GameOfKnowing/ACT_Charger/README.md

# ACT_Charger
A modular, Arduino-based charger for charging and measuring the capacities of many small lithium-polymer batteries
