GameOfKnowing/ACT_Charger/Case/ACT Charger Enclosure Lid.stl

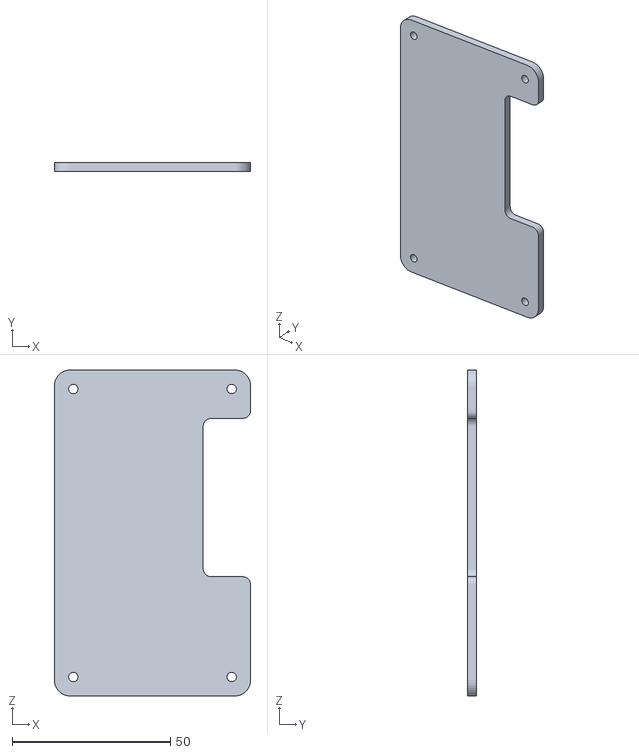
[picture p1: CAD file, 2017-07-28]
Case/ACT Charger Enclosure Lid.stl
62.0 x 3.00 x 103.0
