GameOfKnowing/ACT_Charger/Case/ACT Charger Enclosure Body.stl

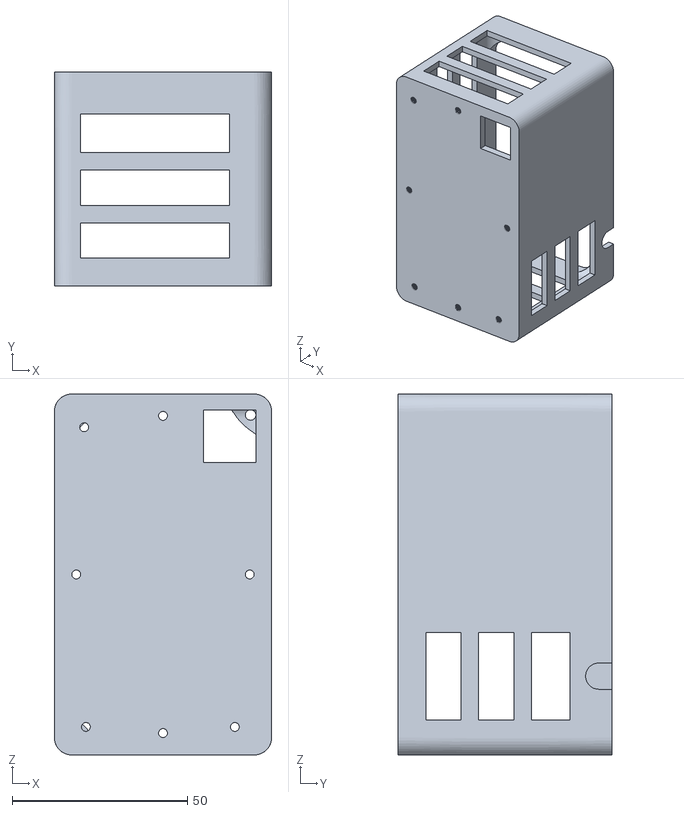
[picture p2: CAD file, 2017-07-28]
Case/ACT Charger Enclosure Body.stl
62.0 x 61.0 x 103.0
