GameOfKnowing/ACT_Charger/EAGLE Files/ACT Lipoly Charger R3 FINAL.brd

## EAGLE design EAGLE Files/ACT Lipoly Charger R3 FINAL.brd (2017-10-17)

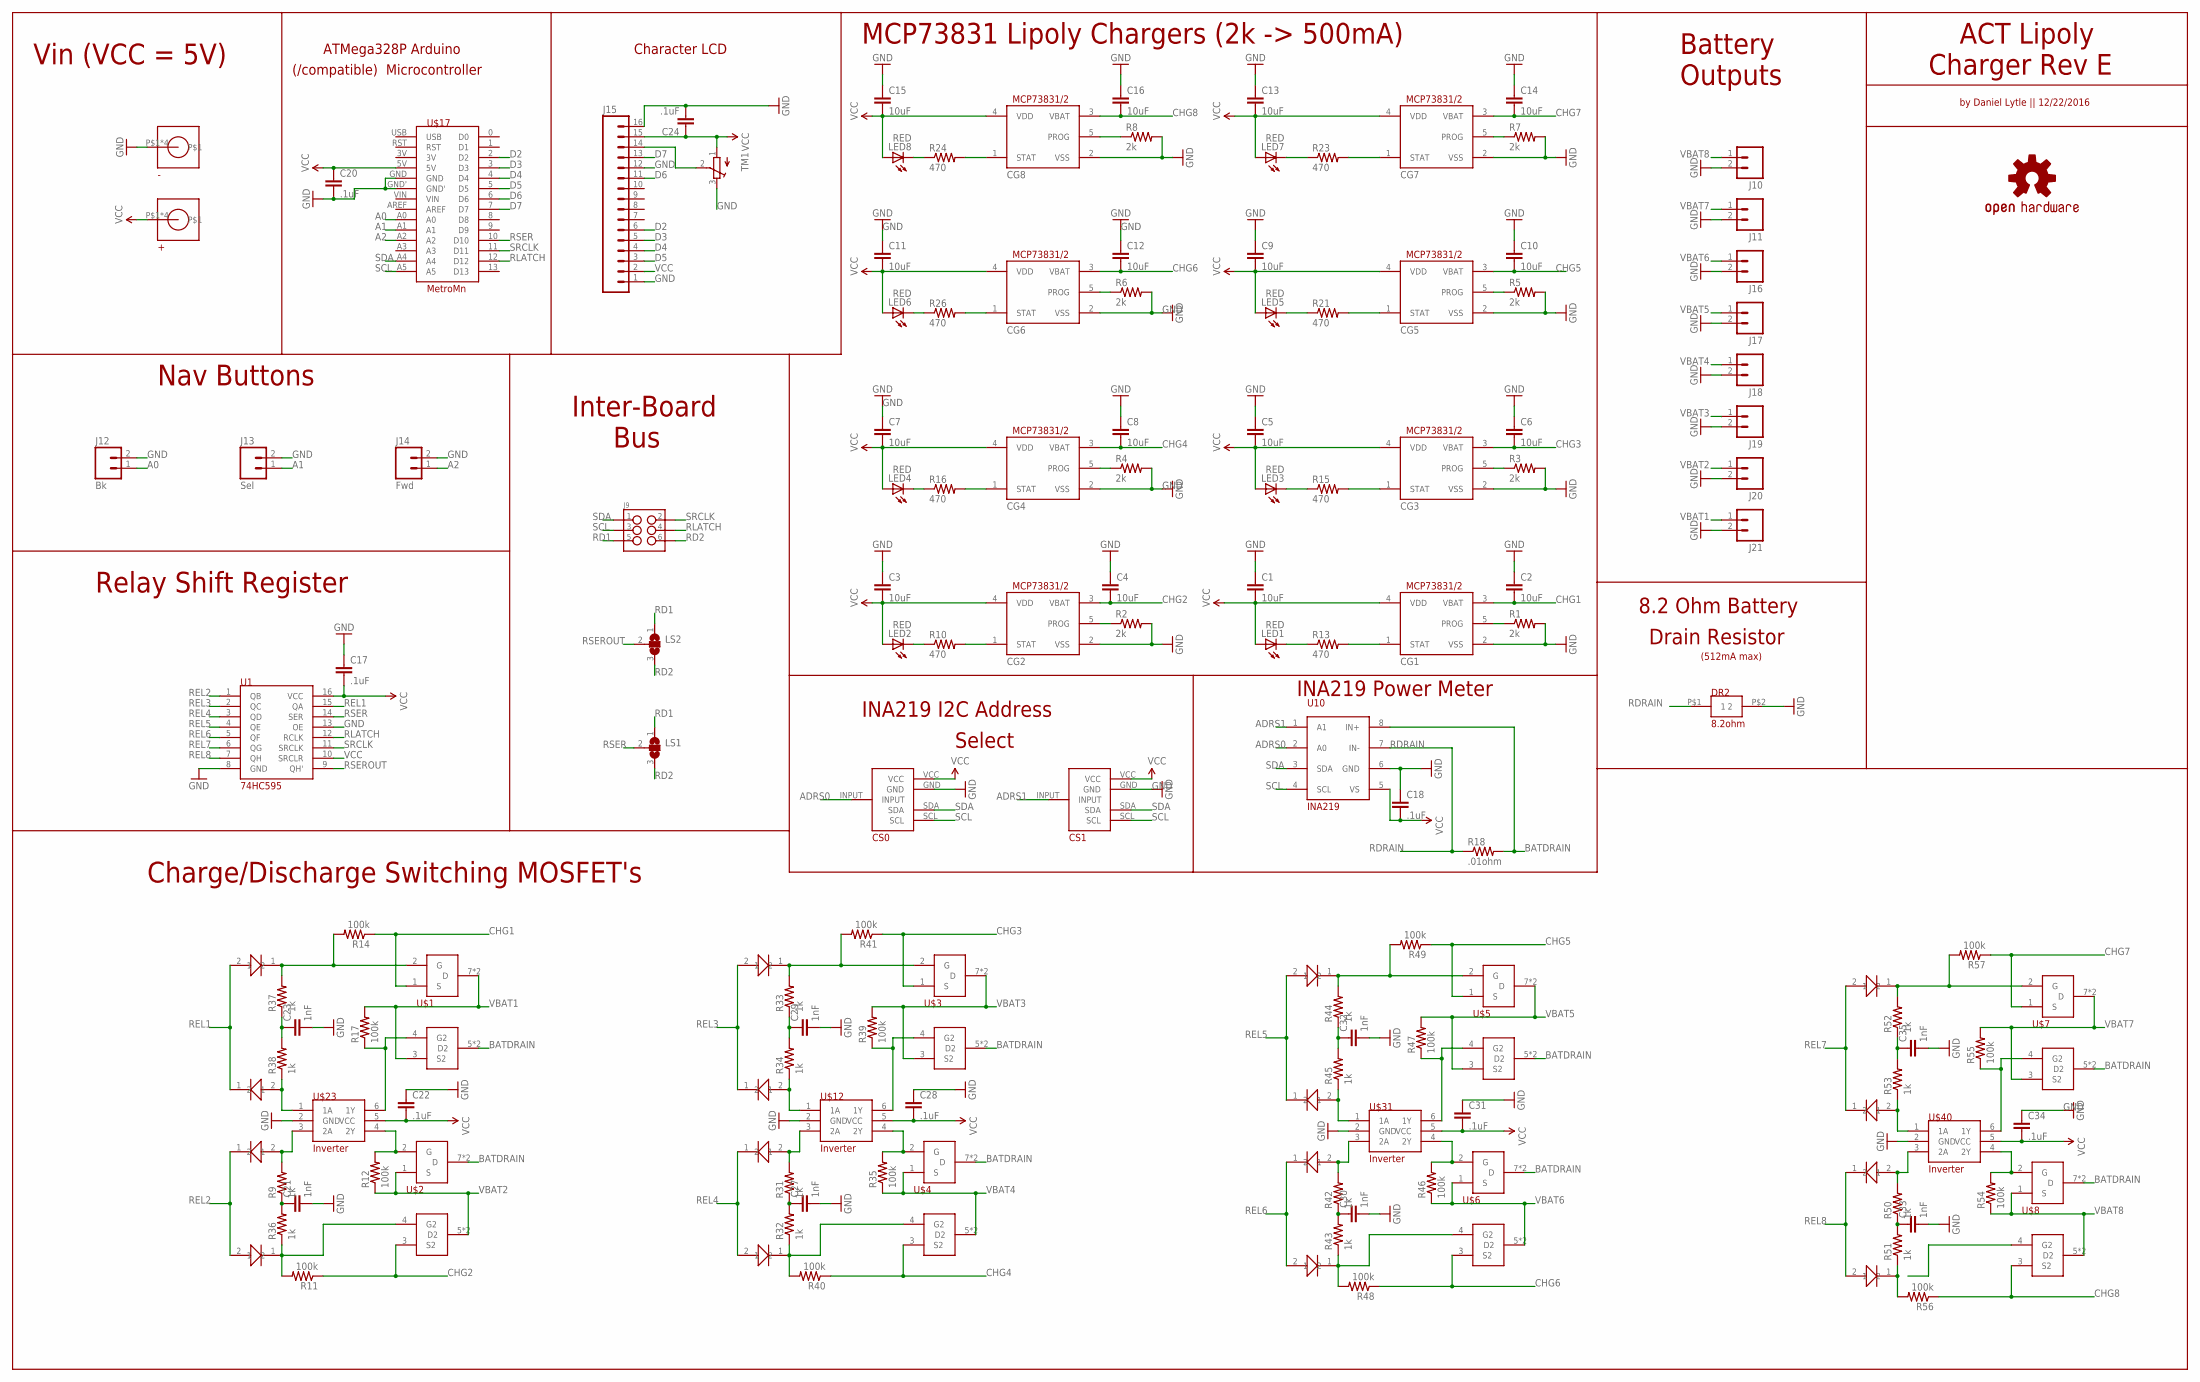
[picture p3: schematic ACT Lipoly Charger R3 FINAL.sch]

Parts:
+: 8191-SEMS; 9191-SEMS
-: 8191-SEMS; 9191-SEMS
C1, C2, C3, C4, C5, C6, C7, C8, C9, C10, C11, C12, C13, C14, C15, C16: 10uF; 0805
C17, C18, C20, C22, C24, C28, C31, C34: .1uF; 0805
C21, C23, C27, C29, C30, C32, C33, C35: 1nF; 0805
CG1, CG2, CG3, CG4, CG5, CG6, CG7, CG8: MCP73831/OT; SOT23-5L
CS0, CS1: 4-WAYSELECTOR
DR2: 8.2ohm; UB5C-5R6F1
J9: M03X2FEMALE; 2X3
J10, J11, J16, J17, J18, J19, J20, J21: M02LOCK_LONGPADS; 1X02_LOCK_LONGPADS
J12: Bk; 1X02_LOCK_LONGPADS
J13: Sel; 1X02_LOCK_LONGPADS
J14: Fwd; 1X02_LOCK_LONGPADS
J15: M16LOCK_LONGPADS; 1X16_LOCK_LONGPADS
LED1, LED2, LED3, LED4, LED5, LED6, LED7, LED8: RED; CHIP-LED0805
LS1, LS2: SJ2W; SJ_2
R1, R2, R3, R4, R5, R6, R7, R8: 2k; 0805
R9, R31, R32, R33, R34, R36, R37, R38, R42, R43, R44, R45, R50, R51, R52, R53: 1k; 0805
R10, R13, R15, R16, R21, R23, R24, R26: 470; 0805
R11, R12, R14, R17, R35, R39, R40, R41, R46, R47, R48, R49, R54, R55, R56, R57: 100k; 0805
R18: .01ohm; 0805
TM1: TRIMPOTTC33X; TC33X
U1: 74HC595; DIL16
U10: INA219; SOIC8
U$1, U$2, U$3, U$4, U$5, U$6, U$7, U$8: DMP3085LSD; SOIC8
U$12, U$23, U$31, U$40: Inverter; SOT363_PHILIPS
U$15, U$16, U$18, U$19, U$26, U$27, U$28, U$29, U$34, U$35, U$36, U$37, U$43, U$44, U$45, U$46: DA2J10100L_DIODE; SOD323
U$17: MetroMn; ADAFRUIT_METRO_MINI
VCC: OSHW-LOGOM-COPPER; OSHW-LOGO-M_COPPER

Connections:
A0: J12.1, U$17.A0
A1: J13.1, U$17.A1
A2: J14.1, U$17.A2
ADRS0: CS0.INPUT, U10.2 (A0)
ADRS1: CS1.INPUT, U10.1 (A1)
BATDRAIN: R18.2, U10.8 (IN+), U$1.5 (D2), U$1.6 (D2), U$2.7 (D), U$2.8 (D), U$3.5 (D2), U$3.6 (D2), U$4.7 (D), U$4.8 (D), U$5.5 (D2), U$5.6 (D2), U$6.7 (D), U$6.8 (D), U$7.5 (D2), U$7.6 (D2), U$8.7 (D), U$8.8 (D)
CHG1: C2.2, CG1.3 (VBAT), R14.1, U$1.1 (S)
CHG2: C4.2, CG2.3 (VBAT), R11.1, U$2.3 (S2)
CHG3: C6.2, CG3.3 (VBAT), R41.1, U$3.1 (S)
CHG4: C8.2, CG4.3 (VBAT), R40.1, U$4.3 (S2)
CHG5: C10.2, CG5.3 (VBAT), R49.1, U$5.1 (S)
CHG6: C12.2, CG6.3 (VBAT), R48.1, U$6.3 (S2)
CHG7: C14.2, CG7.3 (VBAT), R57.1, U$7.1 (S)
CHG8: C16.2, CG8.3 (VBAT), R56.1, U$8.3 (S2)
D2: J15.6, U$17.2 (D2)
D3: J15.5, U$17.3 (D3)
D4: J15.4, U$17.4 (D4)
D5: J15.3, U$17.5 (D5)
D6: J15.11, U$17.6 (D6)
D7: J15.13, U$17.7 (D7)
GND: -.P$1, -.P$2, -.P$3, -.P$4, C1.1, C2.1, C3.1, C4.1, C5.1, C6.1, C7.1, C8.1, C9.1, C10.1, C11.1, C12.1, C13.1, C14.1, C15.1, C16.1, C17.1, C18.1, C20.2, C21.2, C22.1, C23.2, C24.2, C27.2, C28.1, C29.2, C30.2, C31.1, C32.2, C33.2, C34.1, C35.2, CG1.2 (VSS), CG2.2 (VSS), CG3.2 (VSS), CG4.2 (VSS), CG5.2 (VSS), CG6.2 (VSS), CG7.2 (VSS), CG8.2 (VSS), CS0.GND, CS1.GND, DR2.P$2 (2), J10.2, J11.2, J12.2, J13.2, J14.2, J15.1, J15.12, J15.16, J16.2, J17.2, J18.2, J19.2, J20.2, J21.2, R1.2, R2.2, R3.2, R4.2, R5.2, R6.2, R7.2, R8.2, TM1.3 (E), U1.8 (GND), U1.13 (OE), U10.6 (GND), U$12.2 (GND), U$17.GND, U$17.GND', U$23.2 (GND), U$31.2 (GND), U$40.2 (GND)
unnamed: CG7.1 (STAT), R23.2
unnamed: CG8.5 (PROG), R8.1
unnamed: LED7.C, R23.1
unnamed: CG7.5 (PROG), R7.1
unnamed: CG6.5 (PROG), R6.1
unnamed: CG8.1 (STAT), R24.2
unnamed: CG5.5 (PROG), R5.1
unnamed: CG4.5 (PROG), R4.1
unnamed: LED8.C, R24.1
unnamed: CG3.5 (PROG), R3.1
unnamed: CG2.5 (PROG), R2.1
unnamed: LED6.C, R26.1
unnamed: CG1.5 (PROG), R1.1
unnamed: CG6.1 (STAT), R26.2
unnamed: CG4.1 (STAT), R16.2
unnamed: LED4.C, R16.1
unnamed: LED5.C, R21.1
unnamed: CG5.1 (STAT), R21.2
unnamed: LED3.C, R15.1
unnamed: CG3.1 (STAT), R15.2
unnamed: LED1.C, R13.1
unnamed: CG1.1 (STAT), R13.2
unnamed: CG2.1 (STAT), R10.2
unnamed: LED2.C, R10.1
unnamed: J15.14, TM1.2 (S)
unnamed: R38.1, U$23.1 (1A), U$29.2
unnamed: R9.2, U$23.3 (2A), U$28.2
unnamed: C21.1, R9.1, R36.2
unnamed: R11.2, R36.1, U$2.4 (G2), U$26.1
unnamed: R12.2, U$2.2 (G), U$23.4 (2Y)
unnamed: R17.1, U$1.4 (G2), U$23.6 (1Y)
unnamed: C23.1, R37.1, R38.2
unnamed: R14.2, R37.2, U$1.2 (G), U$27.1
unnamed: R31.2, U$12.3 (2A), U$16.2
unnamed: C27.1, R31.1, R32.2
unnamed: R32.1, R40.2, U$4.4 (G2), U$15.1
unnamed: R35.2, U$4.2 (G), U$12.4 (2Y)
unnamed: R34.1, U$12.1 (1A), U$19.2
unnamed: R39.1, U$3.4 (G2), U$12.6 (1Y)
unnamed: R33.2, R41.2, U$3.2 (G), U$18.1
unnamed: C29.1, R33.1, R34.2
unnamed: R42.2, U$31.3 (2A), U$35.2
unnamed: C30.1, R42.1, R43.2
unnamed: R43.1, R48.2, U$6.4 (G2), U$34.1
unnamed: R46.2, U$6.2 (G), U$31.4 (2Y)
unnamed: R45.1, U$31.1 (1A), U$37.2
unnamed: R47.1, U$5.4 (G2), U$31.6 (1Y)
unnamed: R44.2, R49.2, U$5.2 (G), U$36.1
unnamed: C32.1, R44.1, R45.2
unnamed: R50.2, U$40.3 (2A), U$44.2
unnamed: C33.1, R50.1, R51.2
unnamed: R51.1, R56.2, U$43.1
unnamed: R54.2, U$8.2 (G), U$40.4 (2Y)
unnamed: R53.1, U$40.1 (1A), U$46.2
unnamed: R55.1, U$7.4 (G2), U$40.6 (1Y)
unnamed: R52.2, R57.2, U$7.2 (G), U$45.1
unnamed: C35.1, R52.1, R53.2
RD1: J9.5, LS1.1, LS2.1
RD2: J9.6, LS1.3, LS2.3
RDRAIN: DR2.P$1 (1), R18.1, U10.7 (IN-)
REL1: U1.15 (QA), U$27.2, U$29.1
REL2: U1.1 (QB), U$26.2, U$28.1
REL3: U1.2 (QC), U$18.2, U$19.1
REL4: U1.3 (QD), U$15.2, U$16.1
REL5: U1.4 (QE), U$36.2, U$37.1
REL6: U1.5 (QF), U$34.2, U$35.1
REL7: U1.6 (QG), U$45.2, U$46.1
REL8: U1.7 (QH), U$43.2, U$44.1
RLATCH: J9.4, U1.12 (RCLK), U$17.12 (D12)
RSER: LS1.2, U1.14 (SER), U$17.10 (D10)
RSEROUT: LS2.2, U1.9 (QH')
SCL: CS0.SCL, CS1.SCL, J9.3, U10.4 (SCL), U$17.A5
SDA: CS0.SDA, CS1.SDA, J9.1, U10.3 (SDA), U$17.A4
SRCLK: J9.2, U1.11 (SRCLK), U$17.11 (D11)
VBAT1: J21.1, R17.2, U$1.3 (S2), U$1.7 (D), U$1.8 (D)
VBAT2: J20.1, R12.1, U$2.1 (S), U$2.5 (D2), U$2.6 (D2)
VBAT3: J19.1, R39.2, U$3.3 (S2), U$3.7 (D), U$3.8 (D)
VBAT4: J18.1, R35.1, U$4.1 (S), U$4.5 (D2), U$4.6 (D2)
VBAT5: J17.1, R47.2, U$5.3 (S2), U$5.7 (D), U$5.8 (D)
VBAT6: J16.1, R46.1, U$6.1 (S), U$6.5 (D2), U$6.6 (D2)
VBAT7: J11.1, R55.2, U$7.3 (S2), U$7.7 (D), U$7.8 (D)
VBAT8: J10.1, R54.1, U$8.1 (S), U$8.5 (D2), U$8.6 (D2)
VCC: +.P$1, +.P$2, +.P$3, +.P$4, C1.2, C3.2, C5.2, C7.2, C9.2, C11.2, C13.2, C15.2, C17.2, C18.2, C20.1, C22.2, C24.1, C28.2, C31.2, C34.2, CG1.4 (VDD), CG2.4 (VDD), CG3.4 (VDD), CG4.4 (VDD), CG5.4 (VDD), CG6.4 (VDD), CG7.4 (VDD), CG8.4 (VDD), CS0.VCC, CS1.VCC, J15.2, J15.15, LED1.A, LED2.A, LED3.A, LED4.A, LED5.A, LED6.A, LED7.A, LED8.A, TM1.1 (A), U1.10 (SRCLR), U1.16 (VCC), U10.5 (VS), U$12.5 (VCC), U$17.5V, U$23.5 (VCC), U$31.5 (VCC), U$40.5 (VCC)

Notes on the sheet:
ATMega328P Arduino
(/compatible) Microcontroller
Vin (VCC = 5V)
Character LCD
MCP73831 Lipoly Chargers (2k -> 500mA)
Relay Shift Register
Inter-Board
Bus
INA219 I2C Address
Select
INA219 Power Meter
8.2 Ohm Battery
Drain Resistor
Battery
Charge/Discharge Switching MOSFET's
ACT Lipoly
Charger Rev E
by Daniel Lytle || 12/22/2016
Outputs
Nav Buttons
(512mA max)

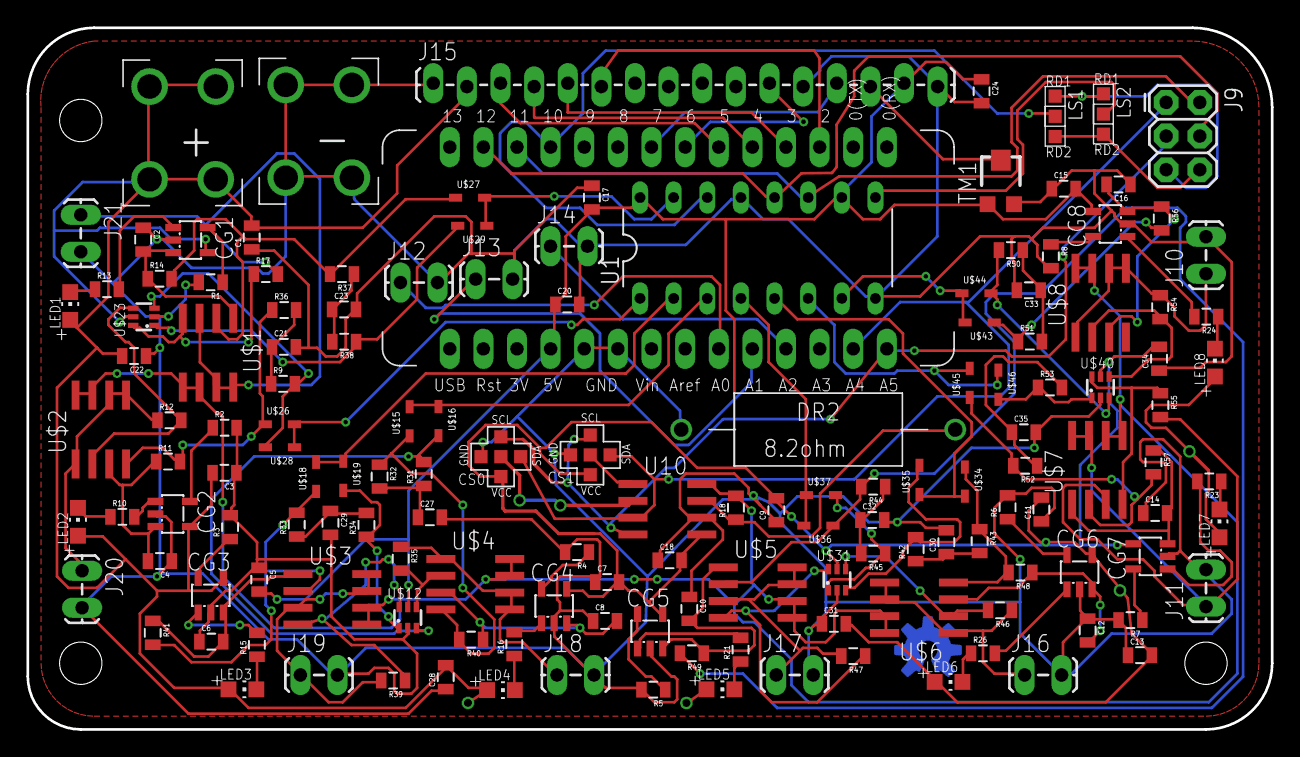
[picture p4: board ACT Lipoly Charger R3 FINAL.brd from above]

Board: 2 copper layers, 94.0 x 53.0 mm, 150 parts (1 on the bottom side), 104 nets.
