GameOfKnowing/ACT_Charger/(commit log)

2017-05-19 Initial commit adds board files and firmware
    [ACT Lipoly Charger R3 FINAL.brd, ACT Lipoly Charger R3 FINAL.sch]
2017-06-13 Improves UI and discharge switching efficiency
2017-06-29 Adds .stl files of first enclosure Rev.A
    [baseplate.stl, stackingShell.stl]
2017-07-01 Add charger manual
2017-07-26 Adds unibody case design, removes modudular case
    [ACT Charger Enclosure Body.stl, ACT Charger Enclosure Lid.stl, baseplate.stl, stackingShell.stl]
2017-07-28 Widened case body mounting holes
    [ACT Charger Enclosure Body.stl]
2017-07-28 Adds holes for USB and display cables
    [ACT Charger Enclosure Body.stl, ACT Charger Enclosure Lid.stl]
2017-10-17 Adds missing LCD signal traces
    [ACT Lipoly Charger R3 FINAL.brd, ACT Lipoly Charger R3 FINAL.sch]
